Steldore/ROV_Axolotl/Built process sample photos/IMG_7721.jpg

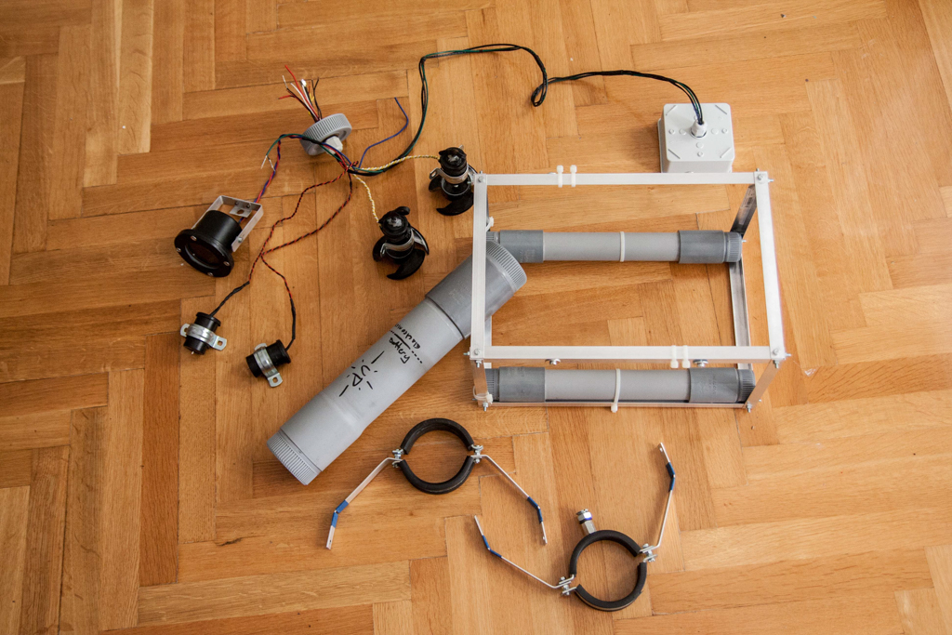
Built process sample photos/IMG_7721.jpg
