Steldore/ROV_Axolotl/Built process sample photos/IMG_7931.jpg

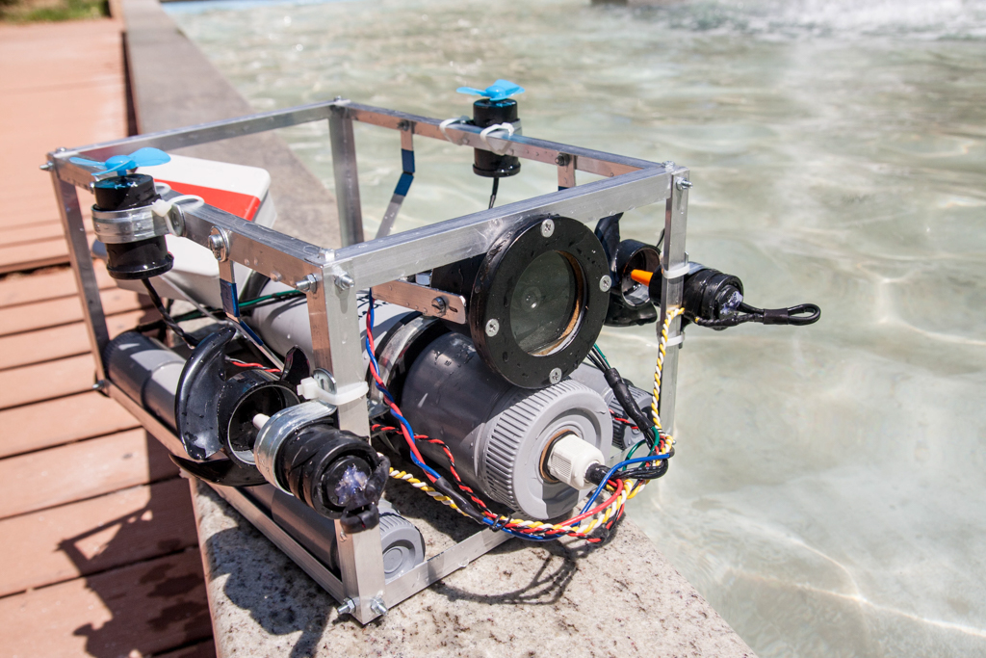
Built process sample photos/IMG_7931.jpg
