Steldore/ROV_Axolotl/Built process sample photos/_MG_6499.jpg

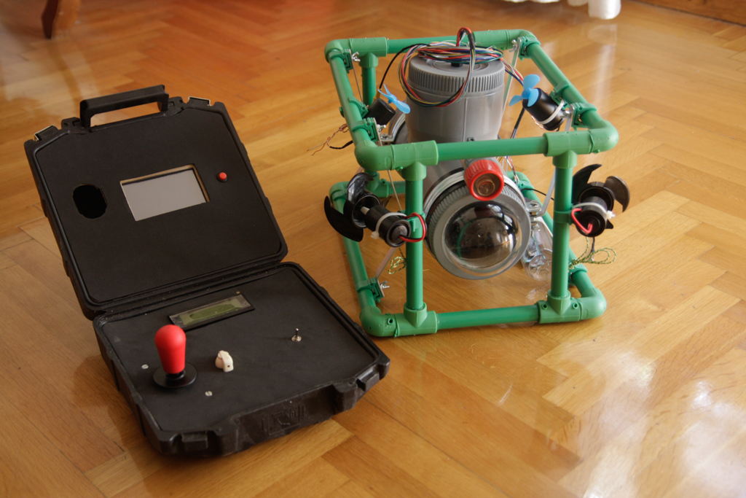
Built process sample photos/_MG_6499.jpg
