Steldore/ROV_Axolotl/Built process sample photos/IMG_7723.jpg

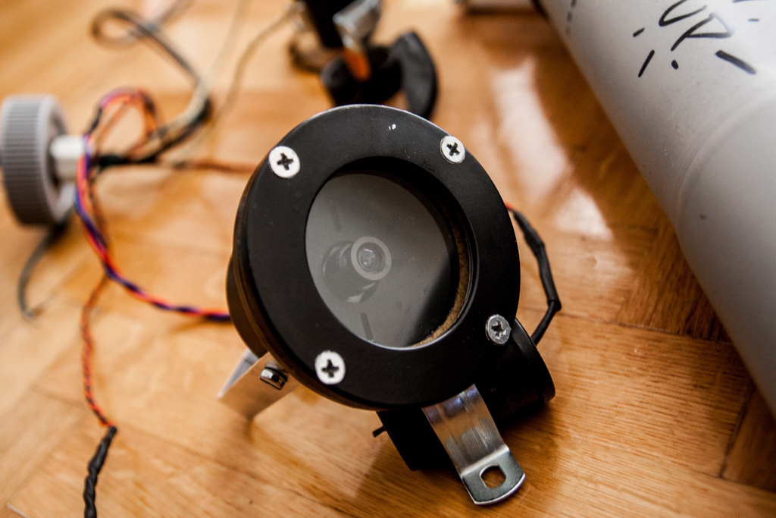
Built process sample photos/IMG_7723.jpg
