Steldore/ROV_Axolotl/Built process sample photos/IMG_7726.jpg

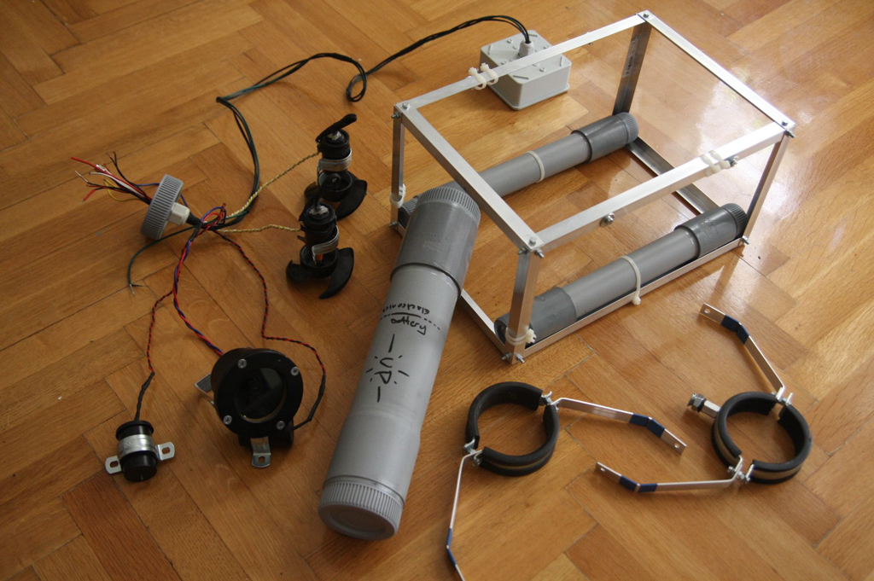
Built process sample photos/IMG_7726.jpg
