Steldore/ROV_Axolotl/Built process sample photos/IMG_7905.jpg

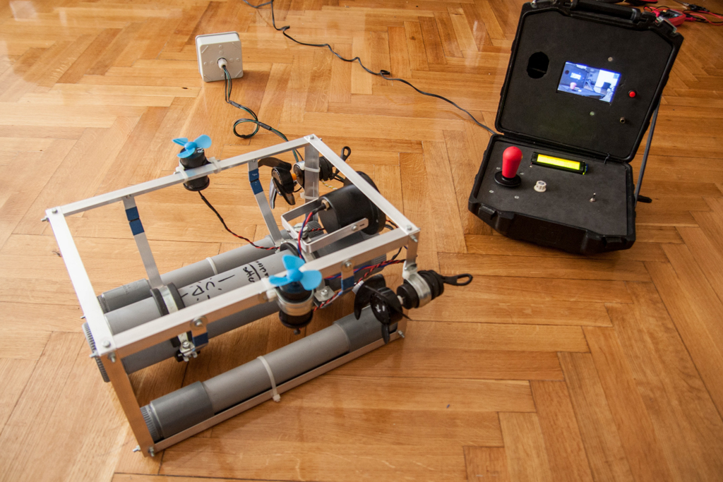
Built process sample photos/IMG_7905.jpg
