Steldore/ROV_Axolotl/Built process sample photos/IMG_7926.jpg

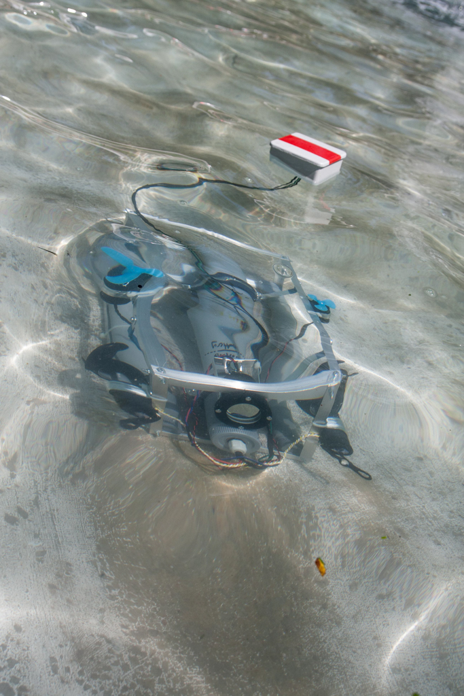
Built process sample photos/IMG_7926.jpg
