Steldore/ROV_Axolotl/Built process sample photos/Untitled-6.jpg

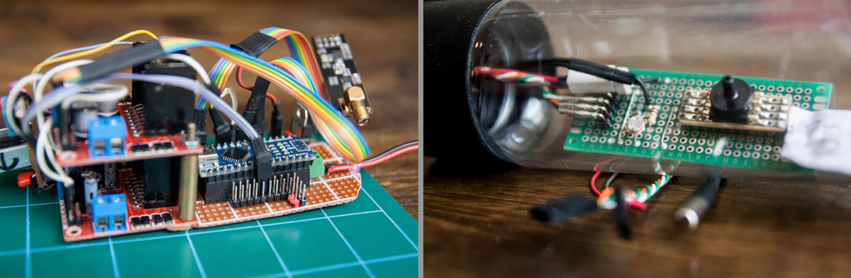
Built process sample photos/Untitled-6.jpg
