Steldore/ROV_Axolotl/log.png

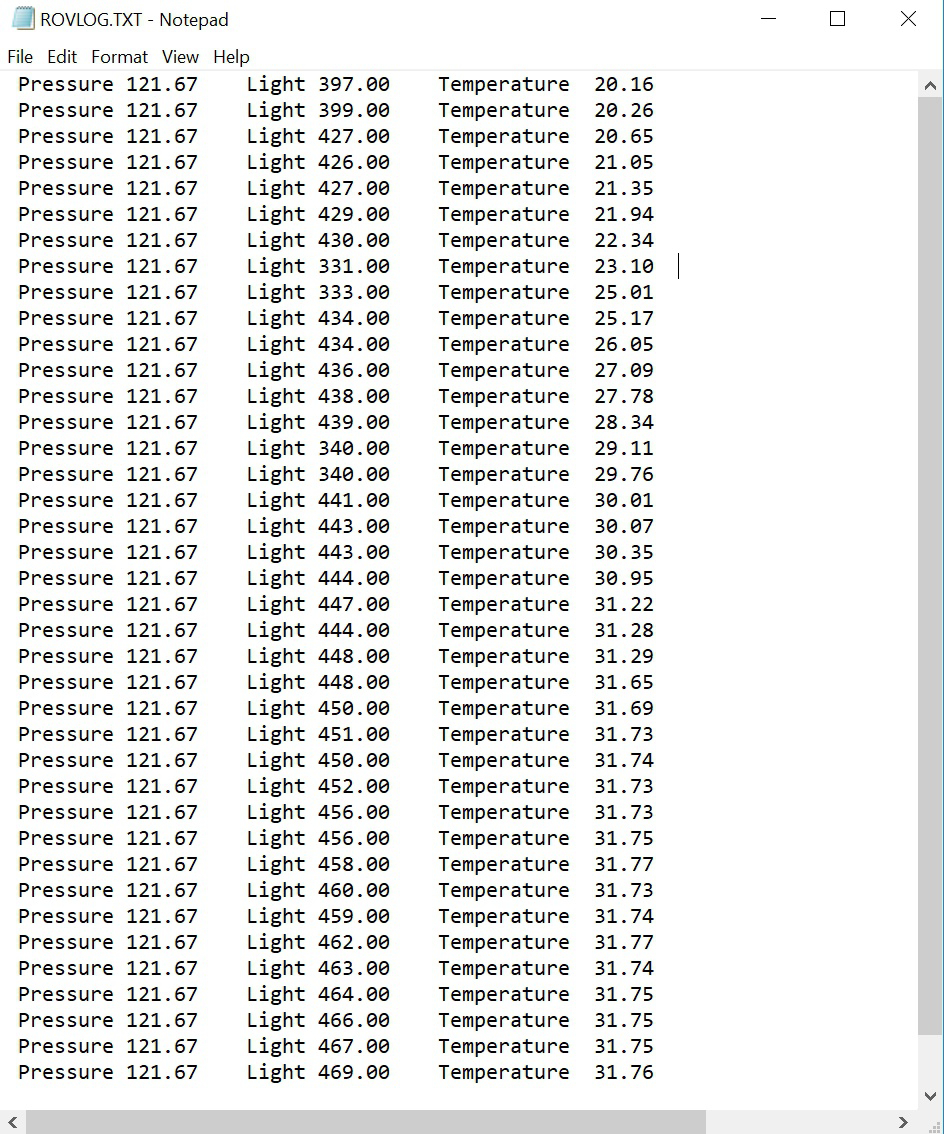
log.png
