Steldore/ROV_Axolotl/Schematics/Controller/base station.png

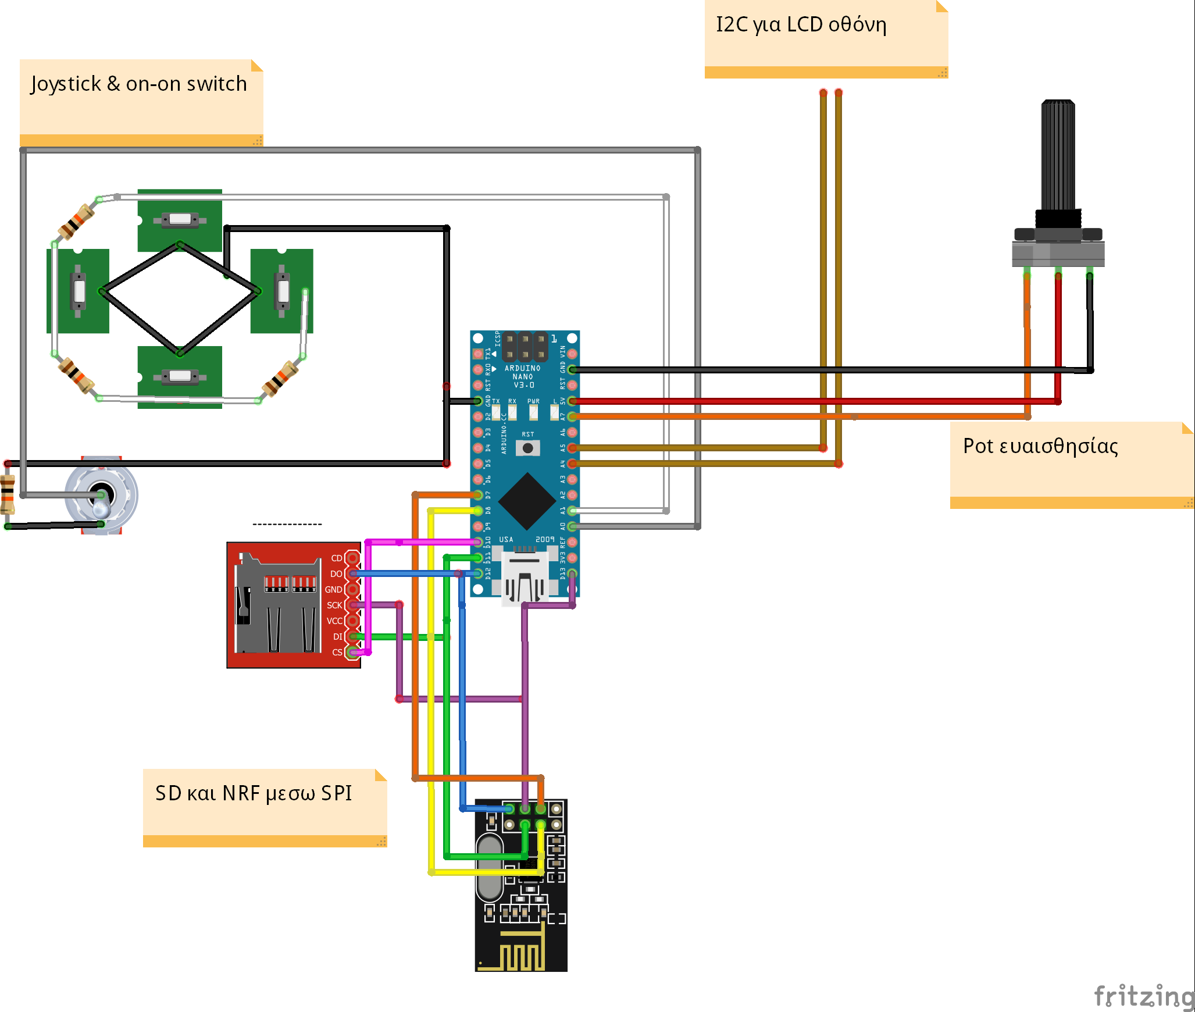
Schematics/Controller/base station.png
