Steldore/ROV_Axolotl/Schematics/Rov_main/rov-constr.png

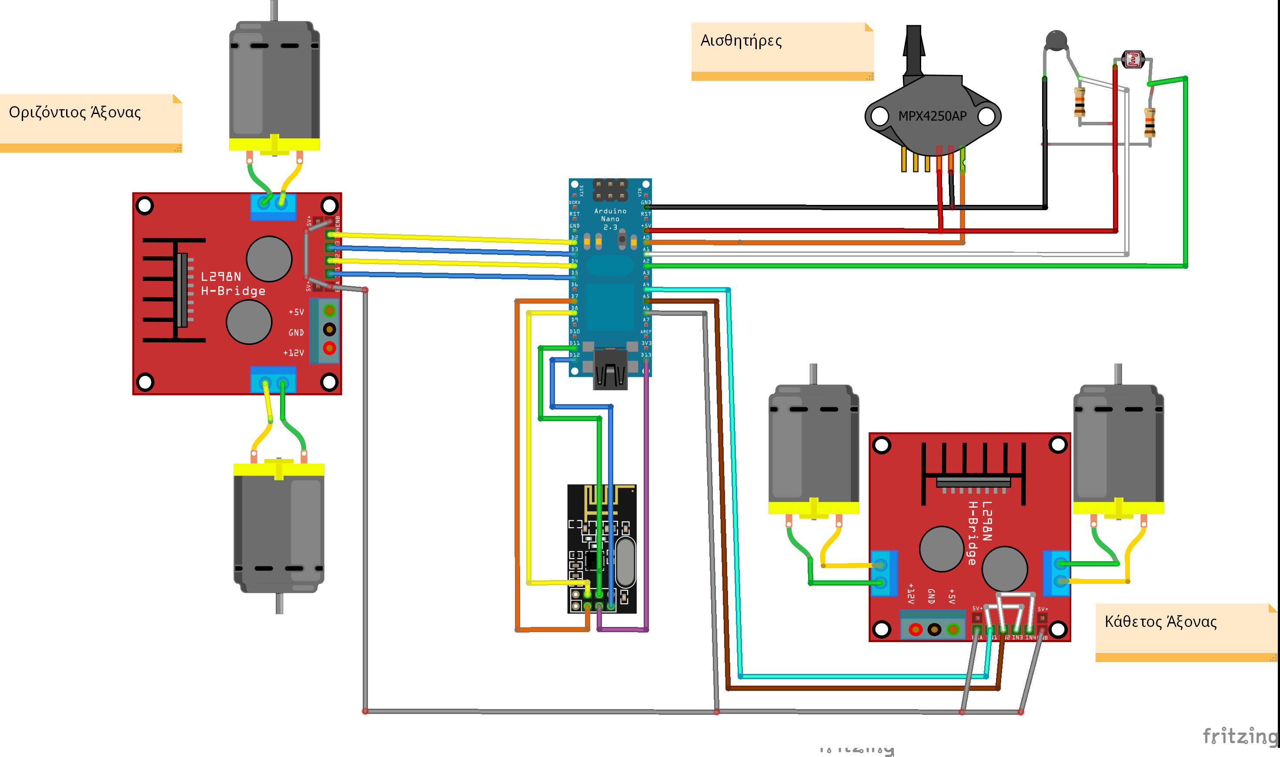
Schematics/Rov_main/rov-constr.png
