Steldore/ROV_Axolotl/Bill of materials/materials.pdf

Parts | Quantity
Arduino Nano | 2
NRF24 plain module | 1
NRF24 high powered module | 1
H-Bridge module L298N | 2
DC-motor | 4 (2 pairs)
prop | 4 (2 pairs)
LDR sensor | 1
NXP pressure sensor | 1
NTC ή PTC temperature sensor | 1
CCTV color camera | 1
SD slot and breakout board | 1
LCD color 5" | 1
LCD 20*8 | 1
I2C for LCD | 1
Potentiometer 10K | 1
Resistors 10K | 1
Chassis power jack | 2
Male power jack | 1
Chassis RCA jack | 1
4-way Joystick with microswitches | 1
78xx family regulators | 4(2 pairs)
Coaxial low loss | 2m
Battery lead acid 12V | 1
AV transmitter / AV Receiver | 1 pair
Aluminum rods | 4m
Aluminum housing | 1
PVC cylinder | 3
ABS cylinder | 1
